vic42/TheWell/pictures/20140920_042.jpg

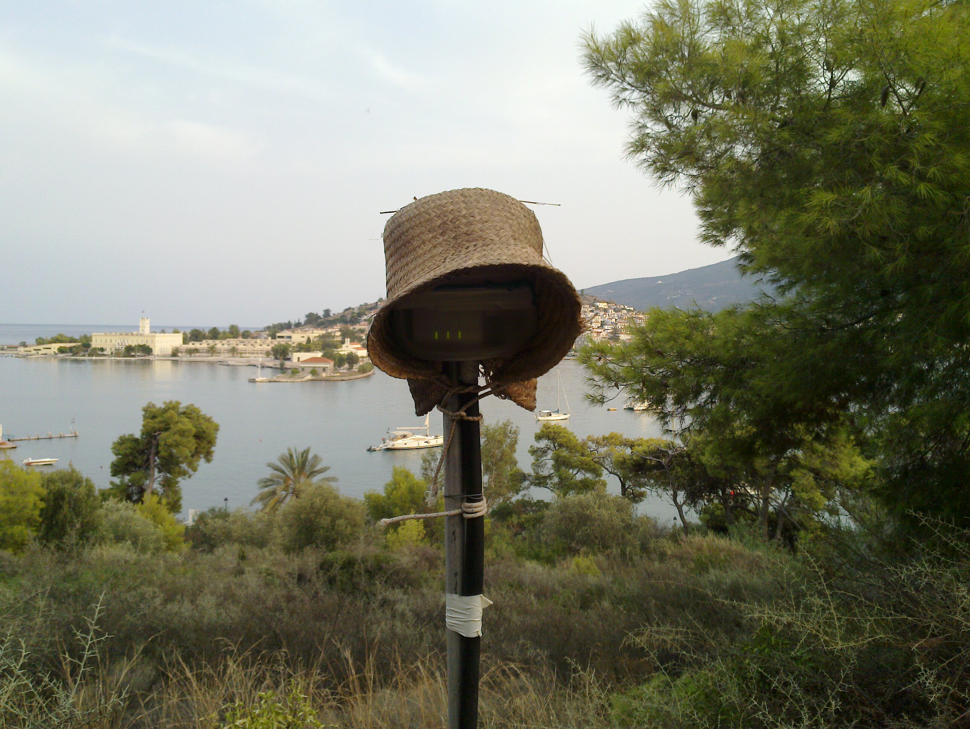
pictures/20140920_042.jpg
