vic42/TheWell/pictures/20140920_026.jpg

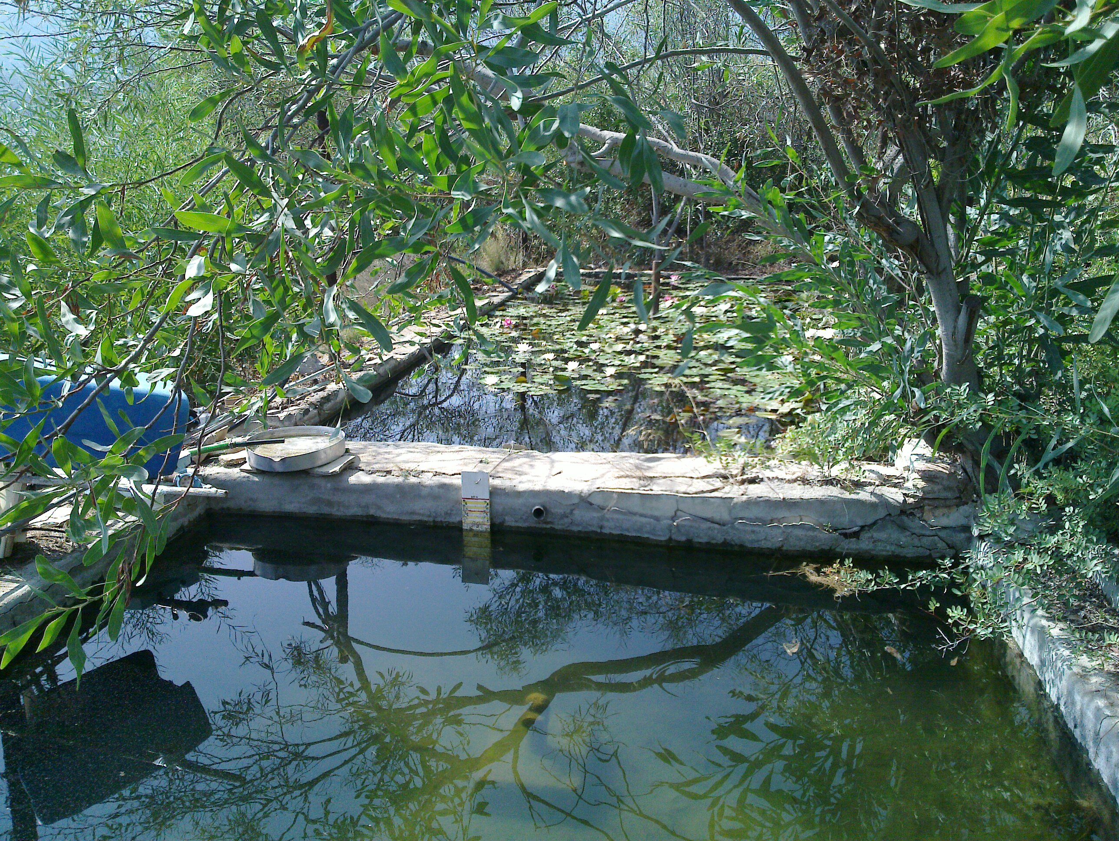
pictures/20140920_026.jpg
