vic42/TheWell/pictures/20140919_006.jpg

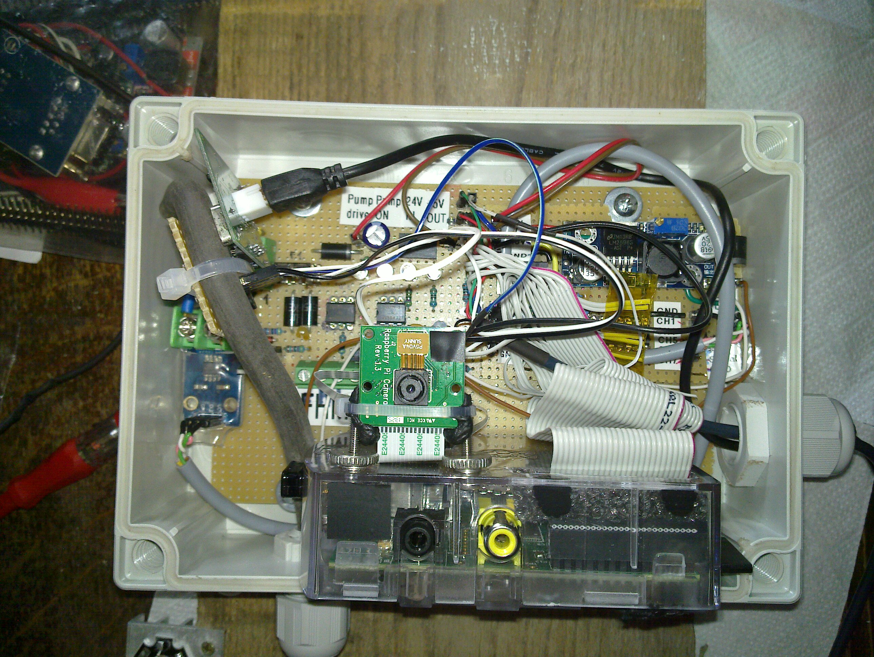
pictures/20140919_006.jpg
