vic42/TheWell/pictures/20140920_013.jpg

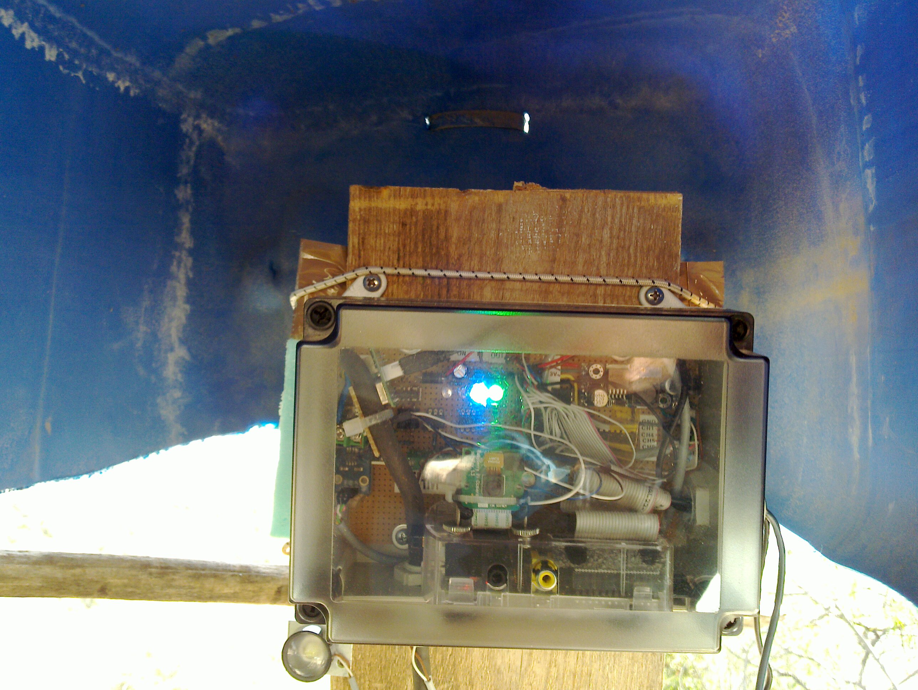
pictures/20140920_013.jpg
