vic42/TheWell/pictures/20140920_014.jpg

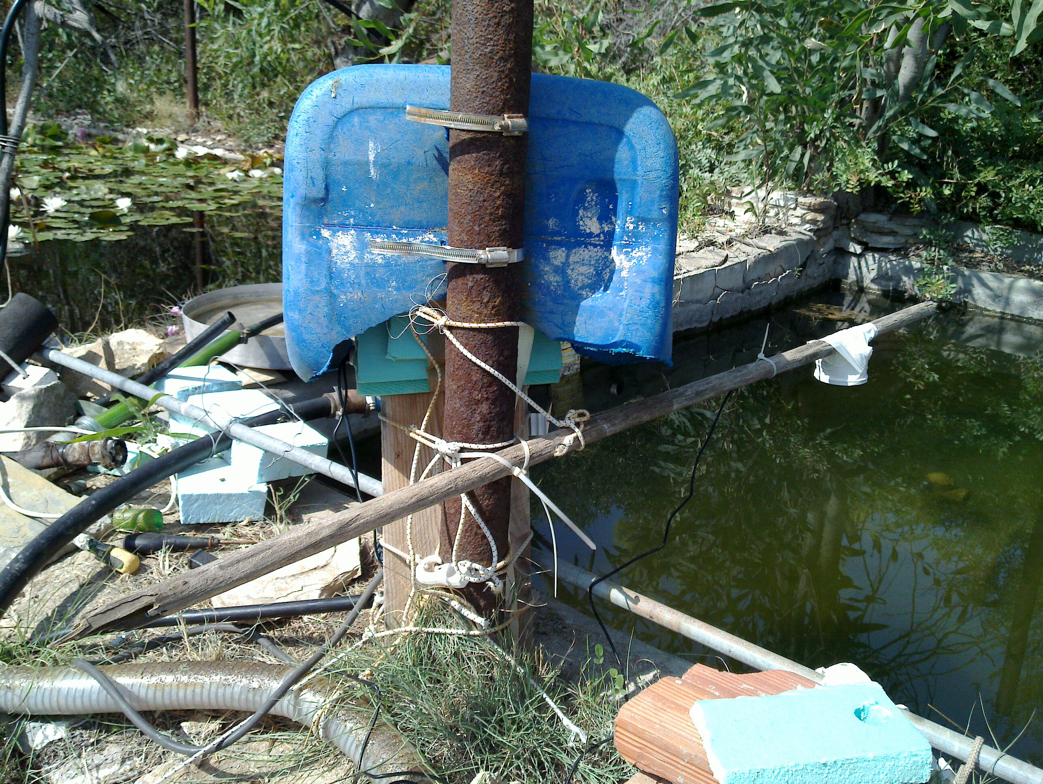
pictures/20140920_014.jpg
