vic42/TheWell/pictures/20140920_032.jpg

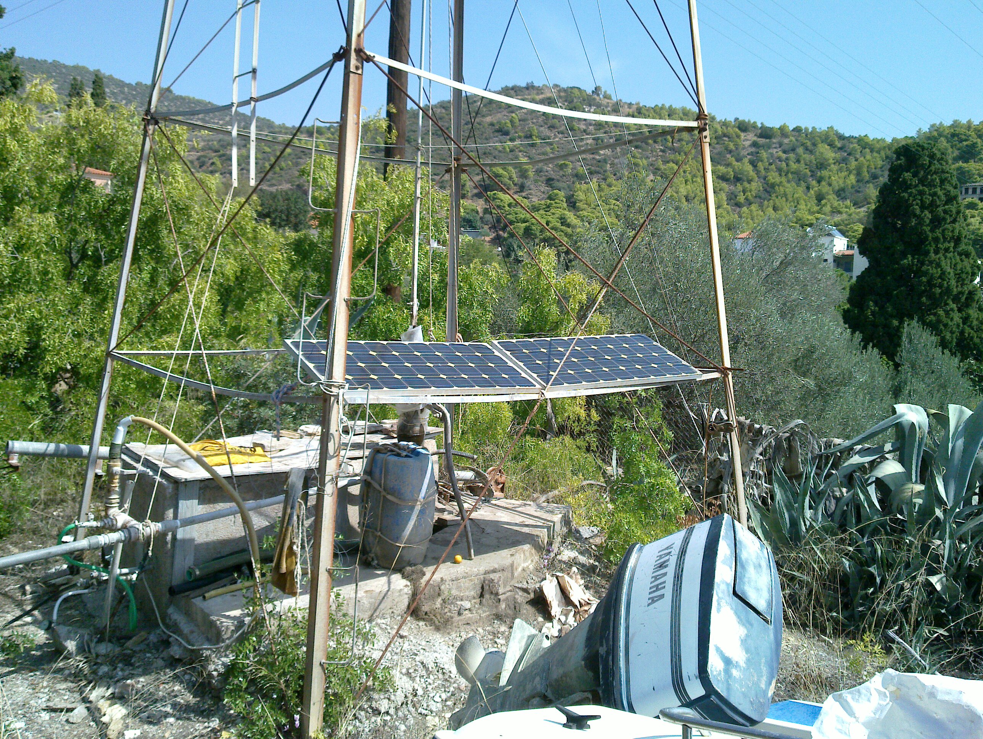
pictures/20140920_032.jpg
