vic42/TheWell/pictures/well1.png

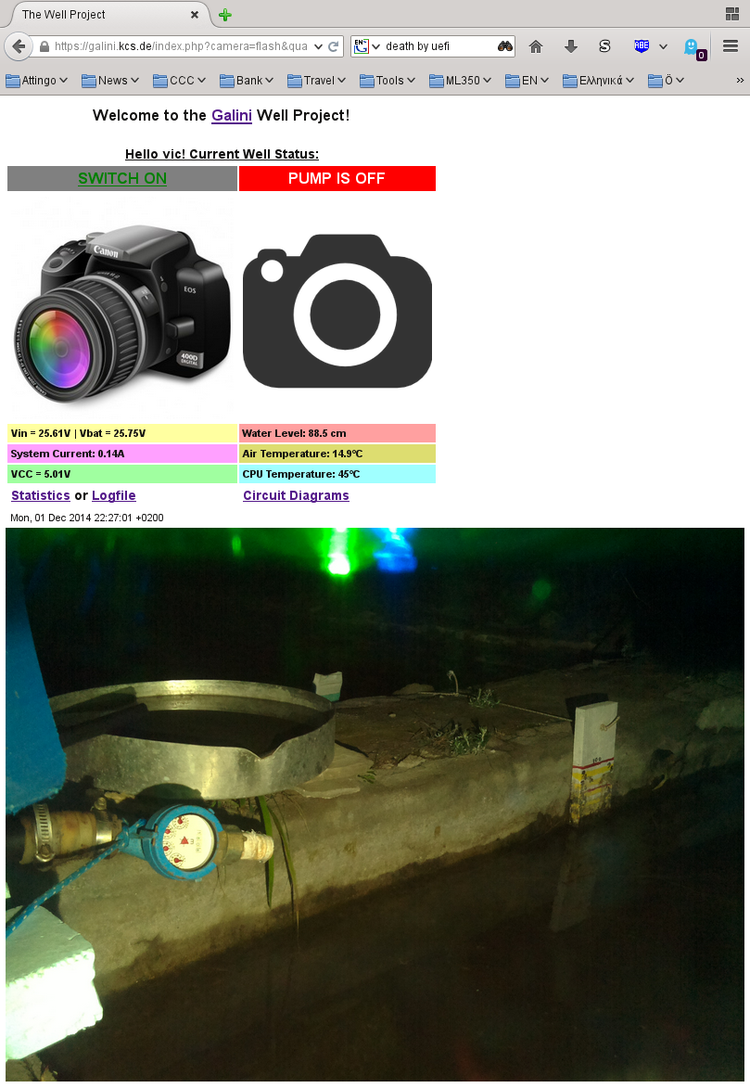
pictures/well1.png
