vic42/TheWell/pictures/well2.png

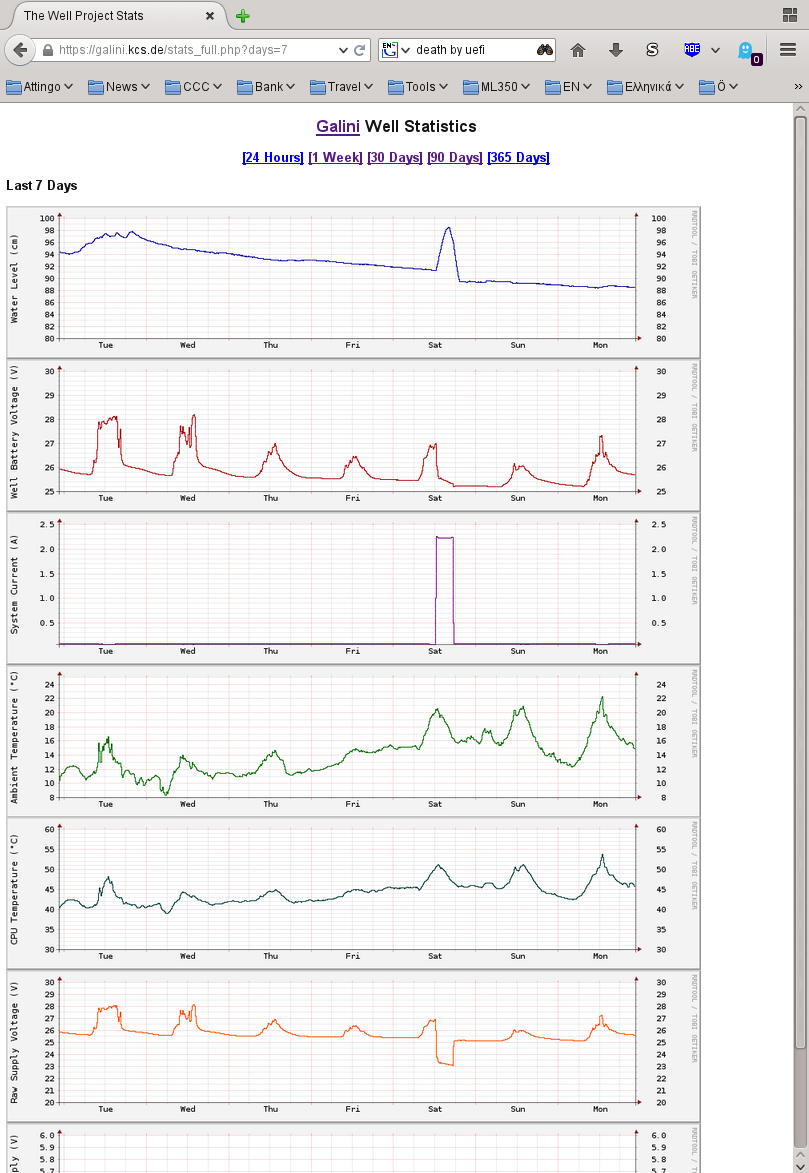
pictures/well2.png
