vic42/TheWell/kicad/well.pdf

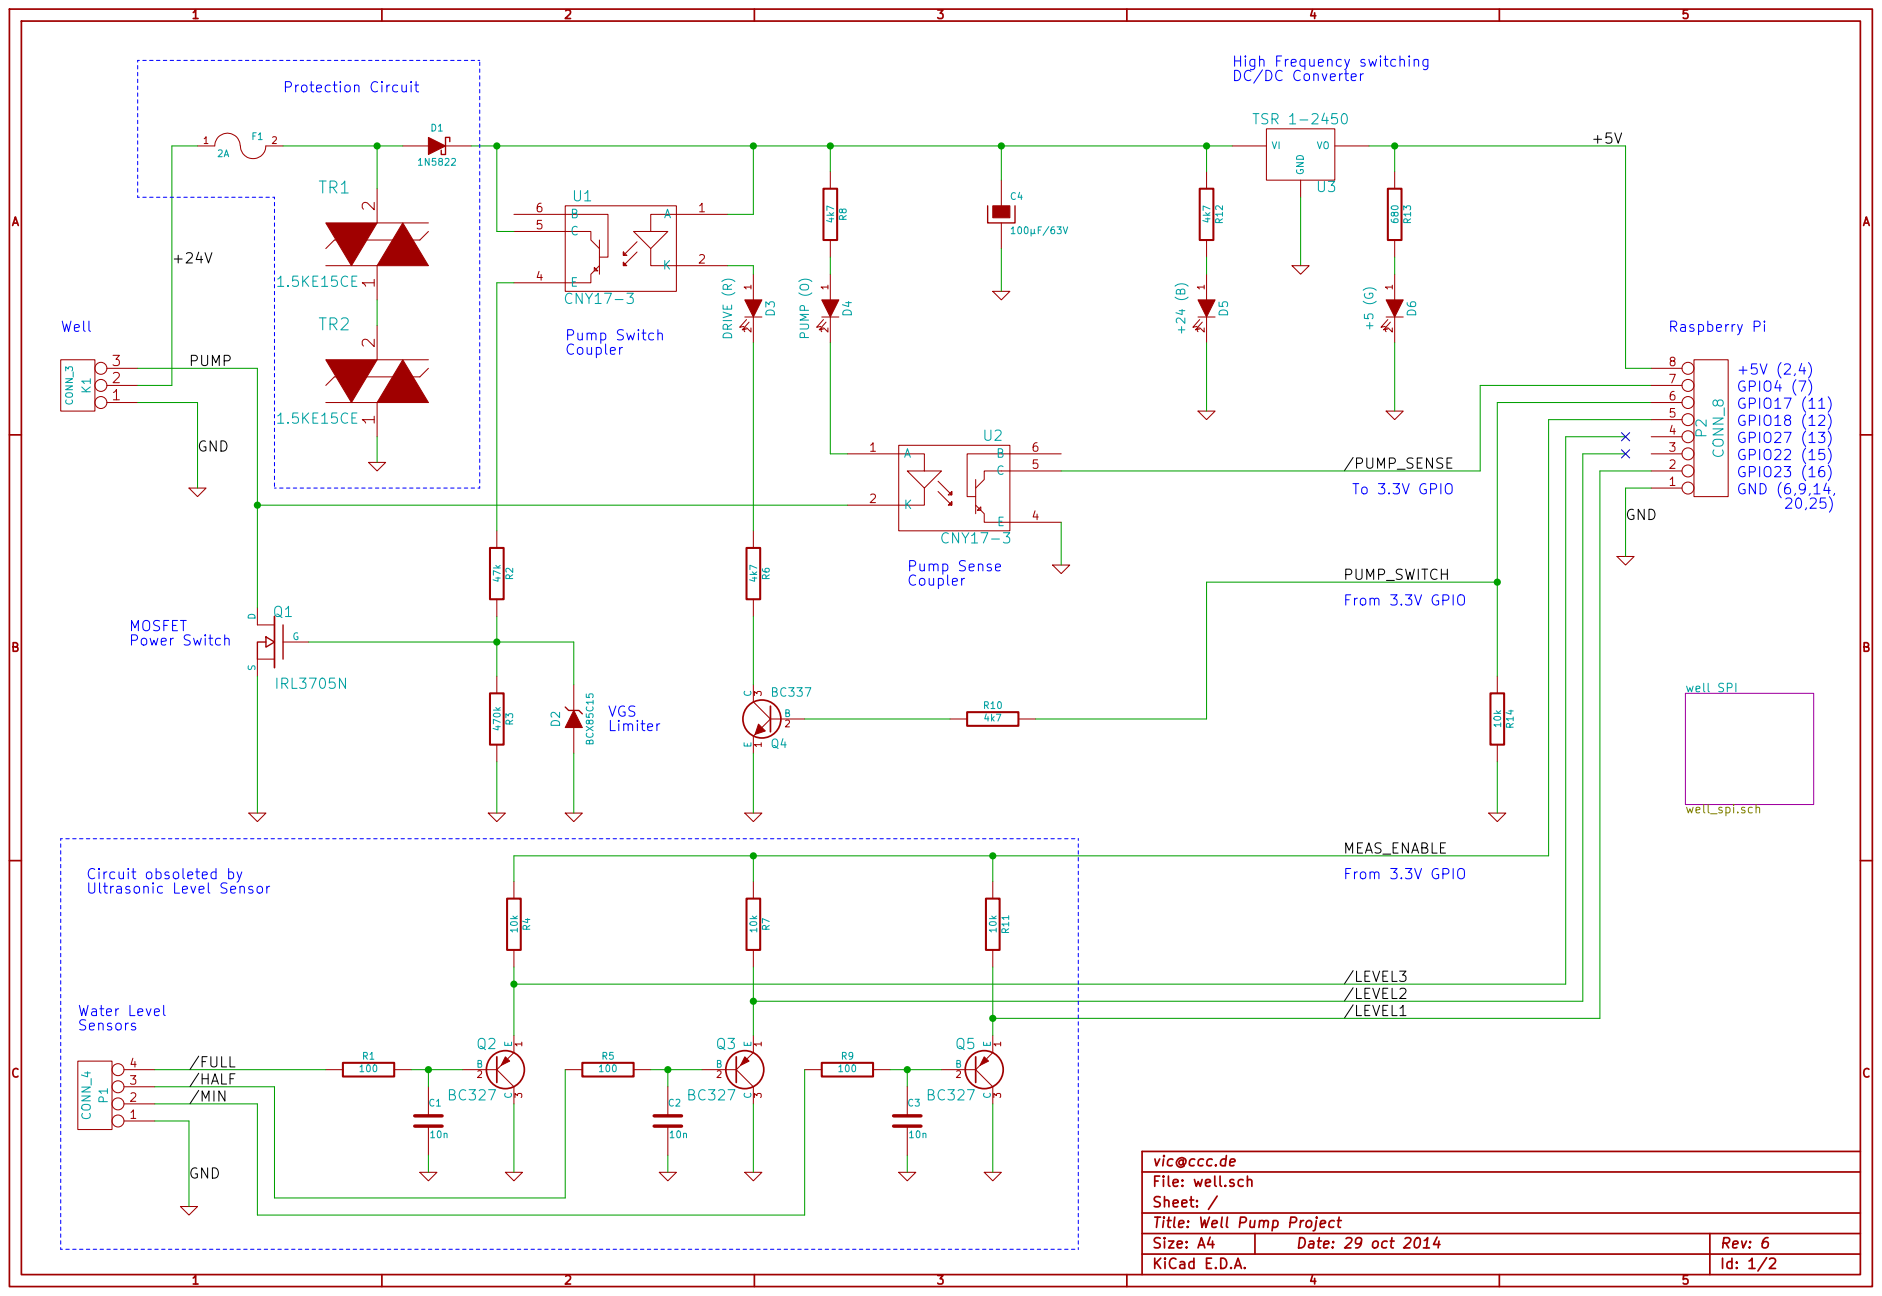
[picture p9: page 1]

DC/DC Converter PUMP

/LEVEL2
/LEVEL1

vic@ccc.de
Title: Well Pump Project File: well.sch Sheet: /

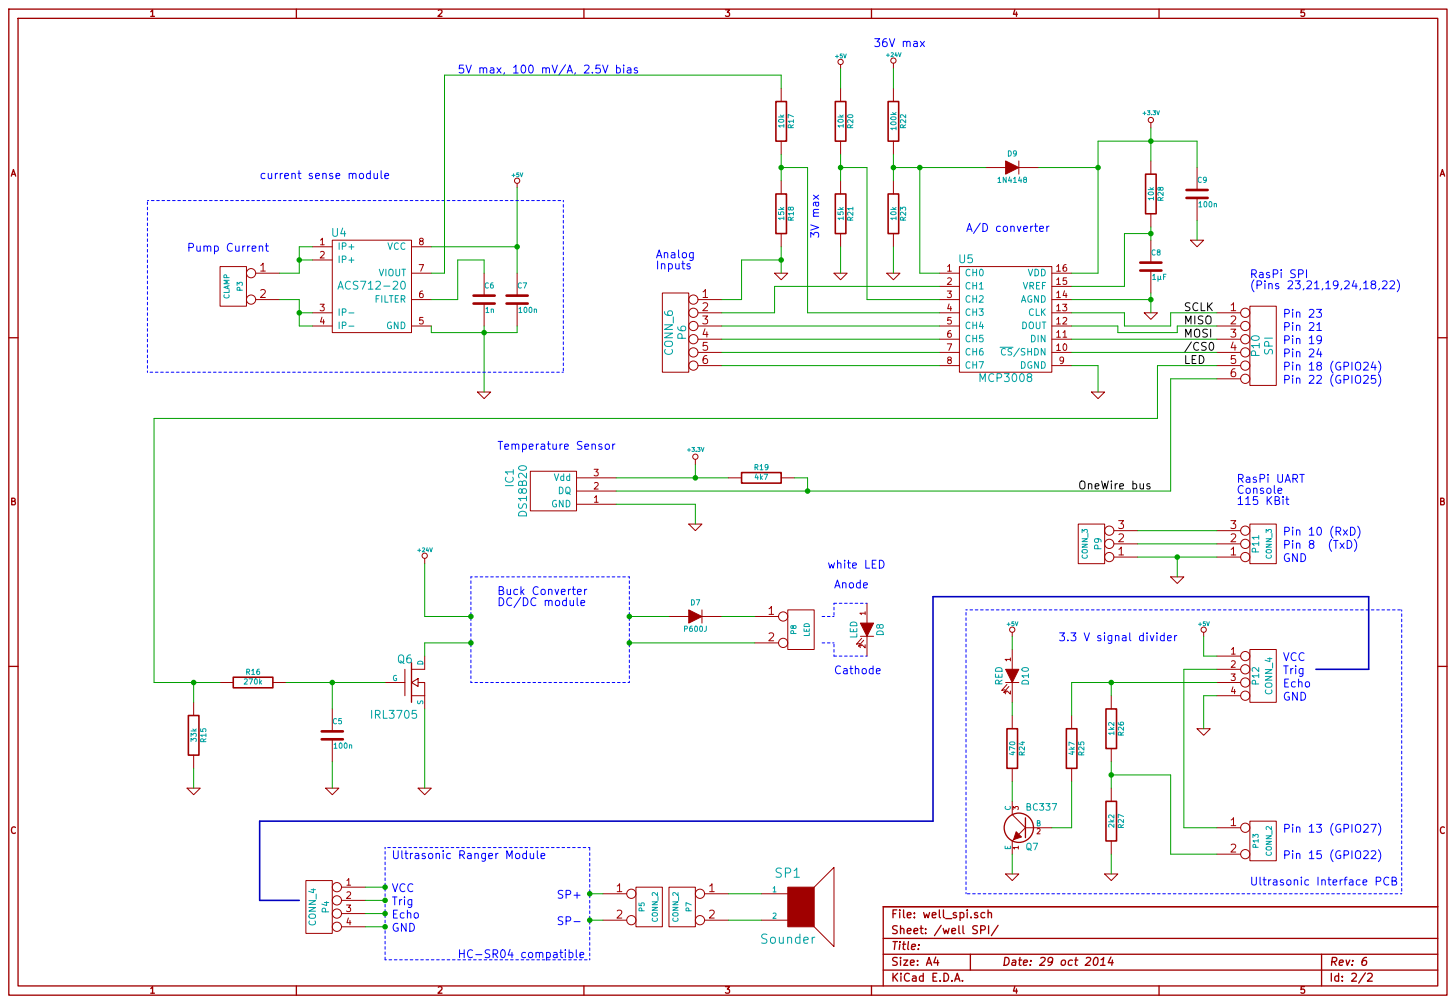
[picture p10: page 2]

A/D converter current sense module

Id: 2/2 Title: File: well_spi.sch
Sheet: /well SPI/
