vic42/TheWell/kicad/well.sch

## KiCad design kicad/well.sch (2017-11-01)

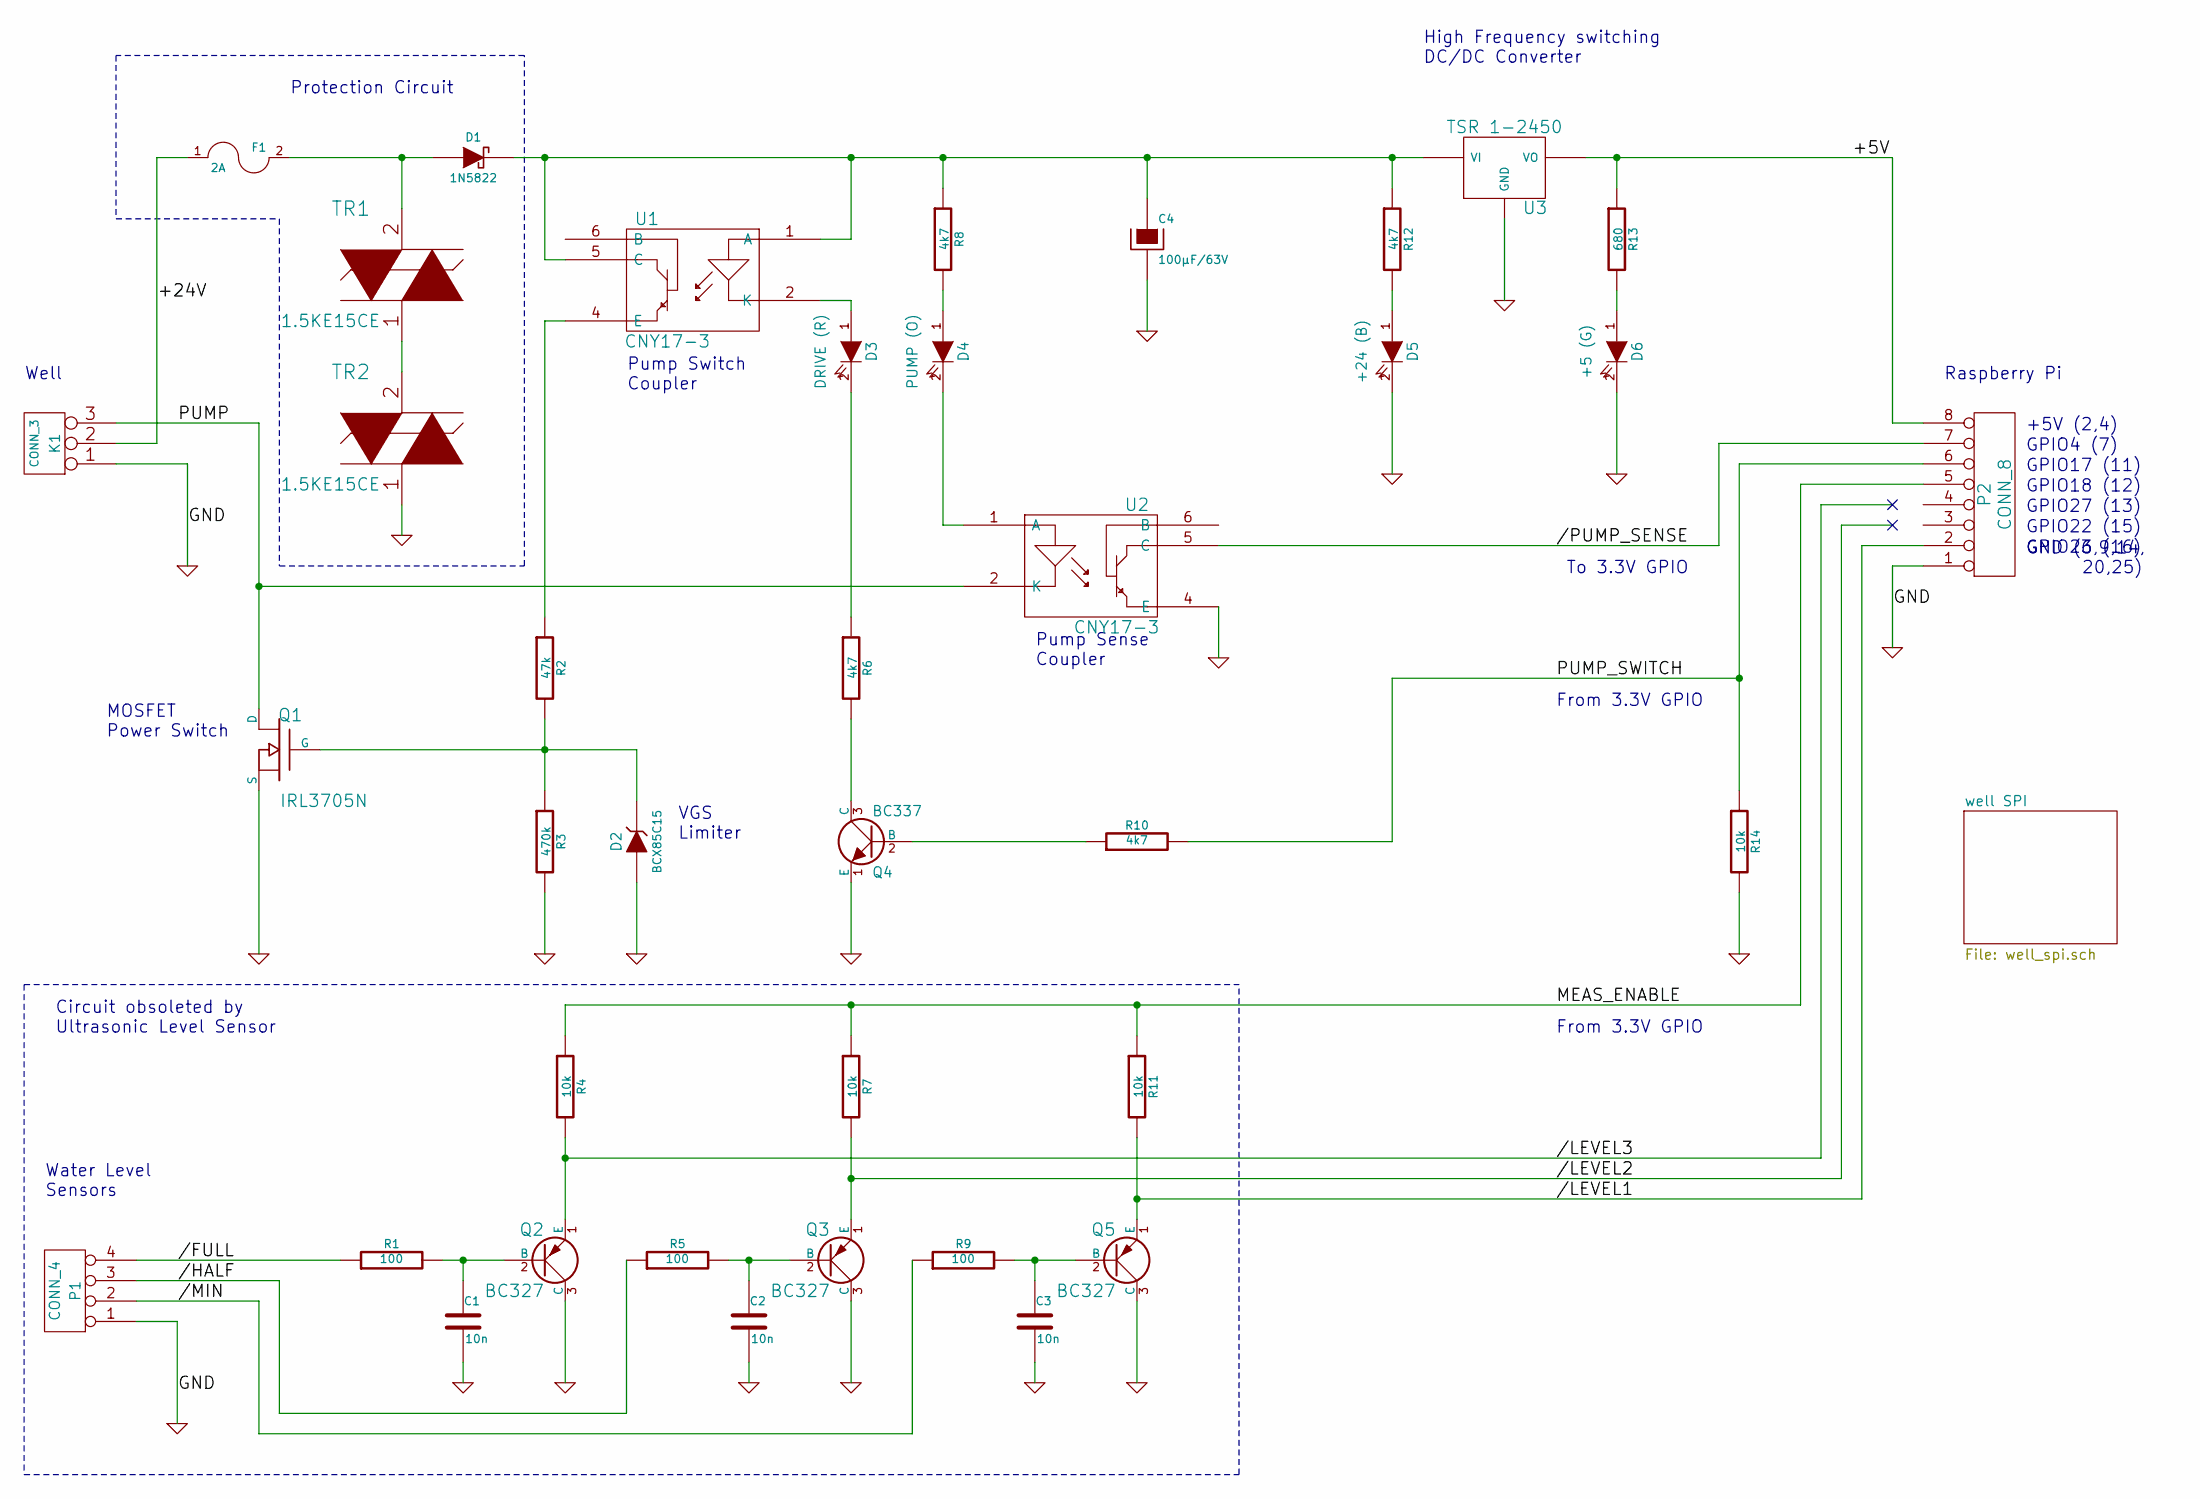
[picture p11: schematic well.sch]

Parts:
C1, C2, C3: 10n
C4: 100µF/63V
D1: 1N5822
D2: BCX85C15
D3: DRIVE (R)
D4: PUMP (O)
D5: +24 (B)
D6: +5 (G)
F1: 2A
K1: CONN_3
P1: CONN_4
P2: CONN_8
Q1: IRL3705N
Q2, Q3, Q5: BC327
Q4: BC337
R1, R5, R9: 100
R2: 47k
R3: 470k
R4, R7, R11, R14: 10k
R6, R8, R10, R12: 4k7
R13: 680
TR1, TR2: 1.5KE15CE
U1, U2: CNY17-3
U3: TSR 1-2450

Connections:
+5V: P2.8, R13.1, U3.VO
+24V: F1.1, K1.2 (PM)
/FULL: P1.4, R1.1
/HALF: P1.3, R5.1
/LEVEL1: P2.2, Q5.1 (E), R11.2
/LEVEL2: Q3.1 (E), R7.2
/LEVEL3: Q2.1 (E), R4.2
/MIN: P1.2, R9.1
/PUMP_SENSE: P2.7, U2.5 (C)
GND: C1.2, C2.2, C3.2, C4.2, D2.1 (A), D5.2 (K), D6.2 (K), K1.1, P1.1, P2.1, Q1.S, Q2.3 (C), Q3.3 (C), Q4.1 (E), Q5.3 (C), R3.2, R14.2, TR2.1, U2.4 (E), U3.GND
MEAS_ENABLE: P2.5, R4.1, R7.1, R11.1
unnamed: C1.1, Q2.2 (B), R1.2
unnamed: C2.1, Q3.2 (B), R5.2
unnamed: C3.1, Q5.2 (B), R9.2
unnamed: C4.1, D1.2 (K), R8.1, R12.1, U1.1 (A), U1.5 (C), U3.VI
unnamed: D1.1 (A), F1.2, TR1.2
unnamed: D2.2 (K), Q1.G, R2.2, R3.1
unnamed: D3.1 (A), U1.2 (K)
unnamed: D3.2 (K), R6.1
unnamed: D4.1 (A), R8.2
unnamed: D4.2 (K), U2.1 (A)
unnamed: D5.1 (A), R12.2
unnamed: D6.1 (A), R13.2
unnamed: Q4.2 (B), R10.1
unnamed: Q4.3 (C), R6.2
unnamed: R2.1, U1.4 (E)
unnamed: TR1.1, TR2.2
PUMP: K1.3, Q1.D, U2.2 (K)
PUMP_SWITCH: P2.6, R10.2, R14.1

Notes on the sheet:
Well
Raspberry Pi
MOSFET Power Switch
VGS Limiter
Protection Circuit
Pump Switch Coupler
Pump Sense Coupler
From 3.3V GPIO
To 3.3V GPIO
High Frequency switching DC/DC Converter
Water Level Sensors
+5V (2,4)
GPIO4 (7)
GPIO17 (11)
GPIO18 (12)
GPIO27 (13)
GPIO22 (15)
GPIO23 (16)
GND (6,9,14, 20,25)
Circuit obsoleted by Ultrasonic Level Sensor
