vic42/TheWell/kicad/well_spi.sch

## KiCad design kicad/well_spi.sch (2017-11-01)

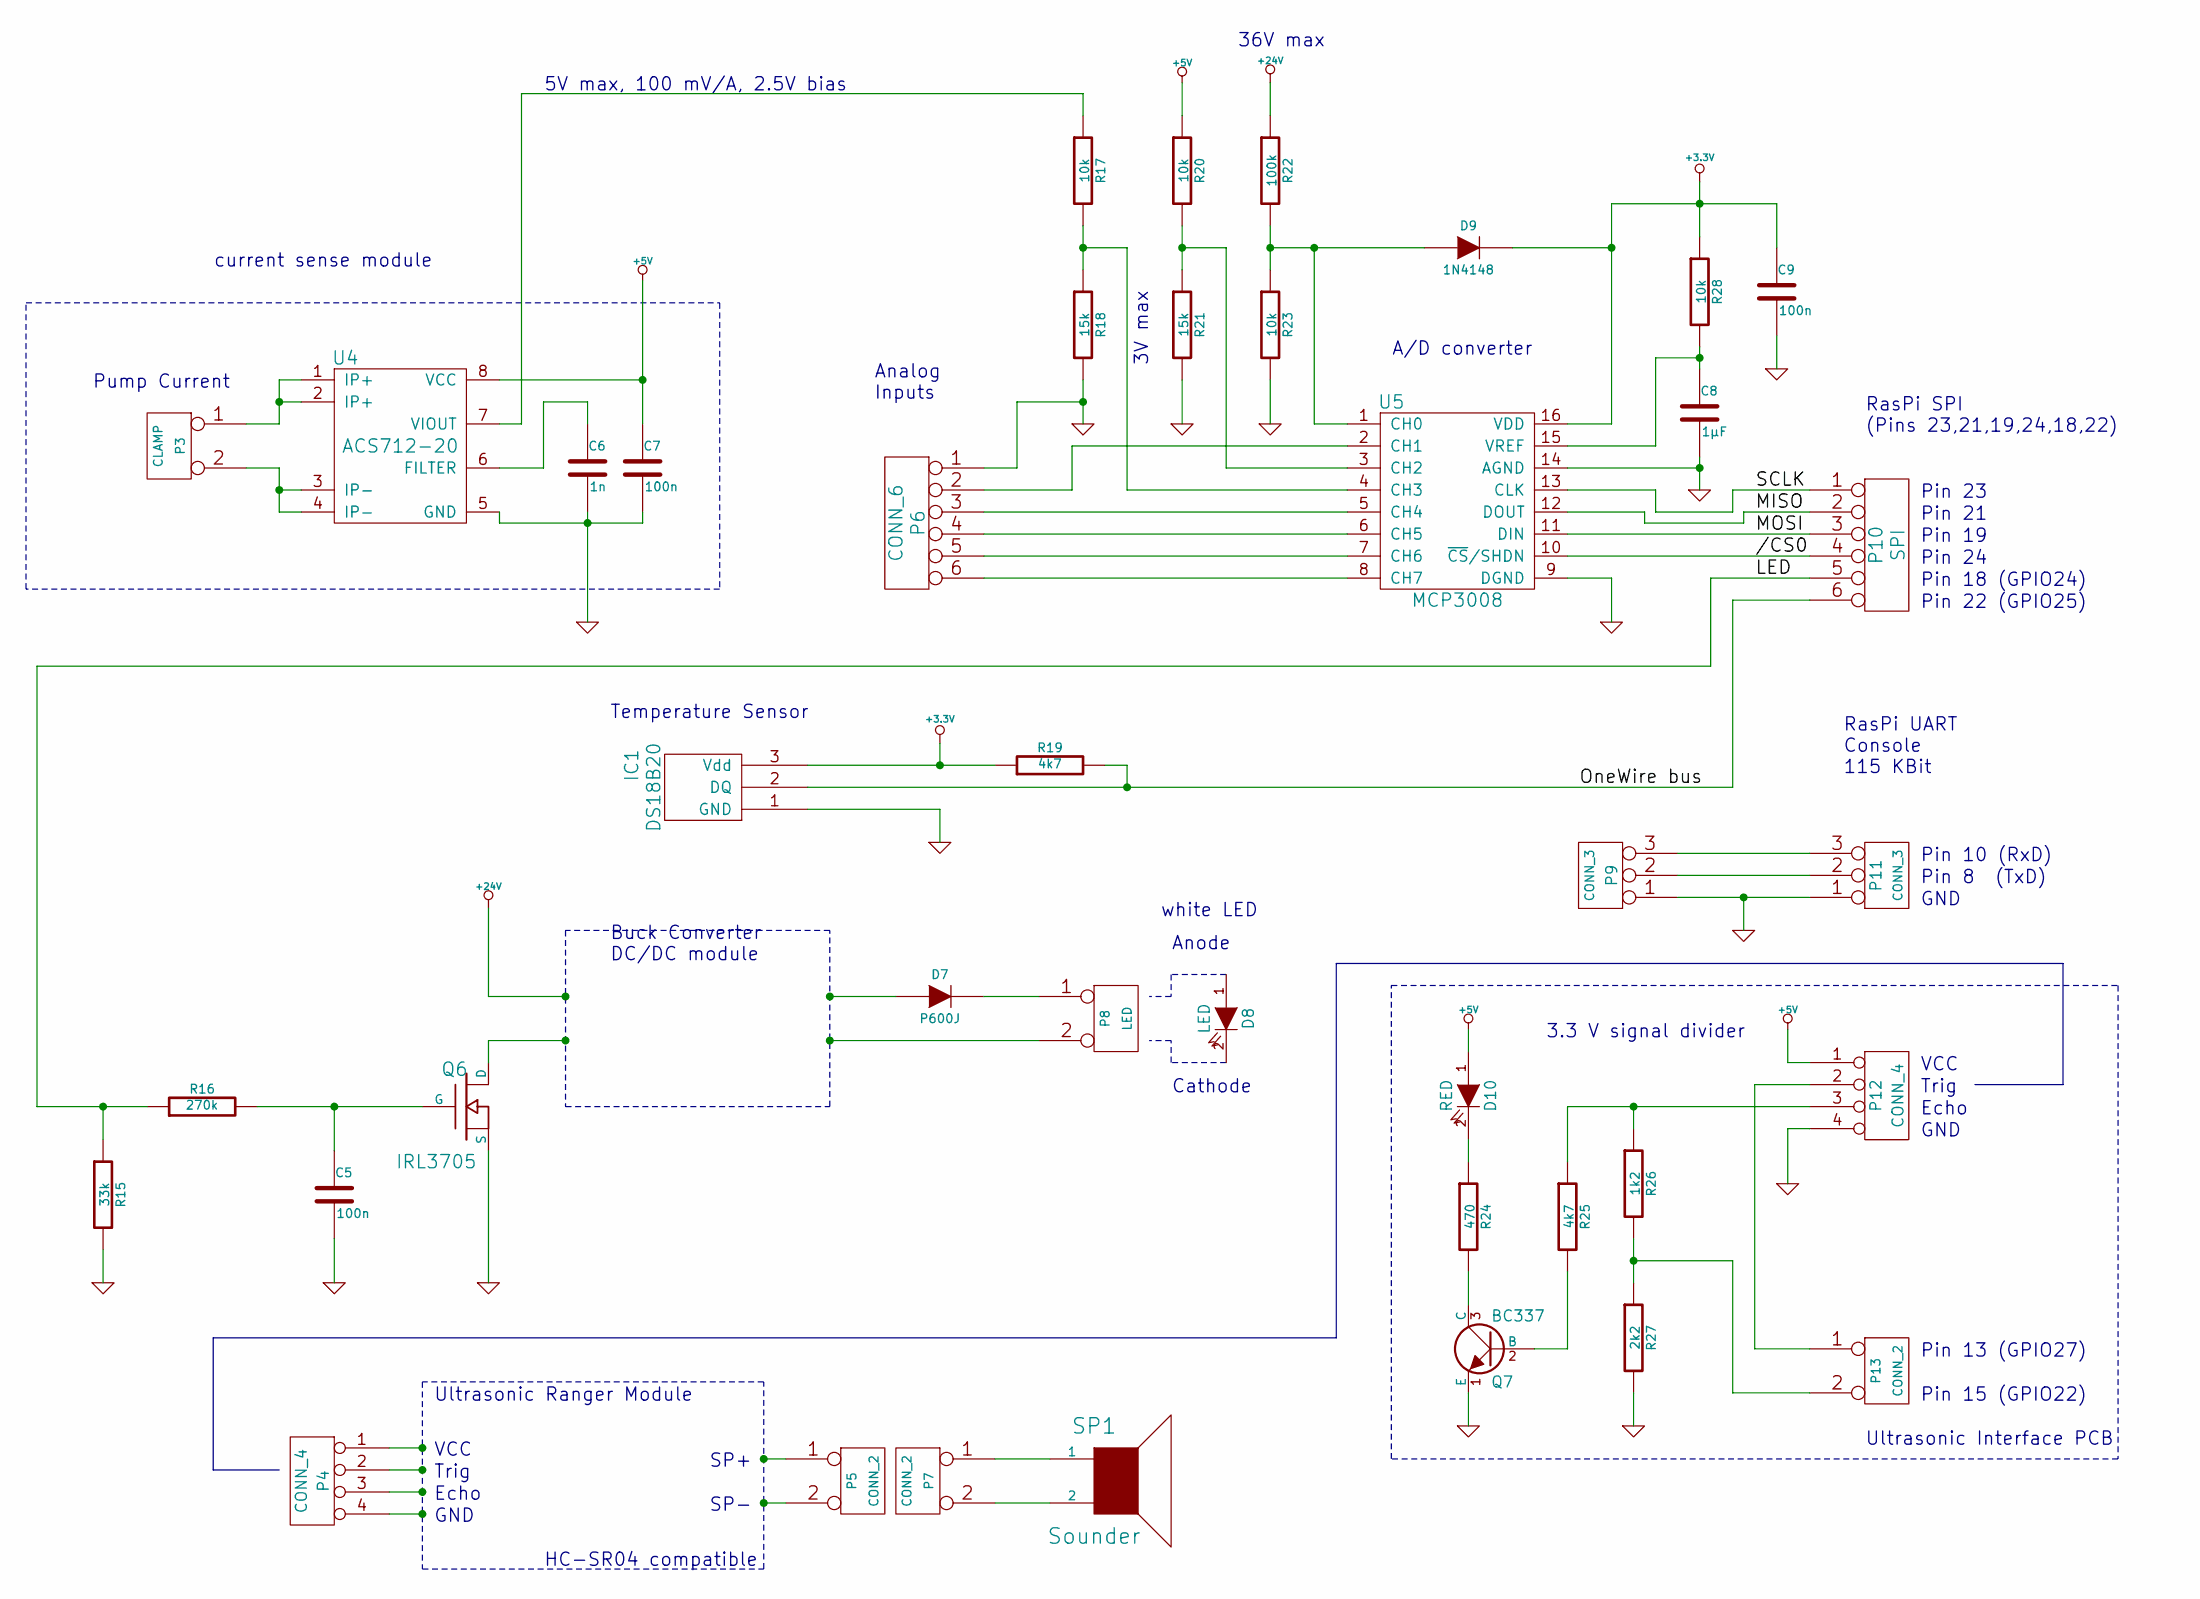
[picture p12: schematic well_spi.sch]

Parts:
C5, C7, C9: 100n
C6: 1n
C8: 1µF
D7: P600J
D8: LED
D9: 1N4148
D10: RED
IC1: DS18B20
P3: CLAMP
P4, P12: CONN_4
P5, P7, P13: CONN_2
P6: CONN_6
P8: LED
P9, P11: CONN_3
P10: SPI
Q6: IRL3705
Q7: BC337
R15: 33k
R16: 270k
R17, R20, R23, R28: 10k
R18, R21: 15k
R19, R25: 4k7
R22: 100k
R24: 470
R26: 1k2
R27: 2k2
SP1: Sounder
U4: ACS712-20
U5: MCP3008

Connections:
+3.3V: C9.1, D9.2 (K), IC1.3 (Vdd), R19.1, R28.1, U5.16 (VDD)
+5V: C7.1, D10.1 (A), P12.1, R20.1, U4.8 (VCC)
+24V: R22.1
/CS0: P10.4, U5.10 (~CS~/SHDN)
GND: C5.2, C6.2, C7.2, C8.2, C9.2, IC1.1 (GND), P6.1, P9.1, P11.1, P12.4, Q6.S, Q7.1 (E), R15.2, R18.2, R21.2, R23.2, R27.2, U4.5 (GND), U5.9 (DGND), U5.14 (AGND)
LED: P10.5, R15.1, R16.1
MISO: P10.2, U5.12 (DOUT)
MOSI: P10.3, U5.11 (DIN)
unnamed: C5.1, Q6.G, R16.2
unnamed: C6.1, U4.6 (FILTER)
unnamed: C8.1, R28.2, U5.15 (VREF)
unnamed: D7.2 (K), P8.1
unnamed: D9.1 (A), R22.2, R23.1, U5.1 (CH0)
unnamed: D10.2 (K), R24.1
unnamed: P3.1, U4.1 (IP+), U4.2 (IP+)
unnamed: P3.2 (PM), U4.3 (IP-), U4.4 (IP-)
unnamed: P6.2, U5.2 (CH1)
unnamed: P6.3, U5.5 (CH4)
unnamed: P6.4, U5.6 (CH5)
unnamed: P6.5, U5.7 (CH6)
unnamed: P6.6, U5.8 (CH7)
unnamed: P7.1, SP1.1
unnamed: P7.2 (PM), SP1.2
unnamed: P9.2 (PM), P11.2 (PM)
unnamed: P9.3, P11.3
unnamed: P12.2, P13.1
unnamed: P12.3, R25.1, R26.1
unnamed: P13.2 (PM), R26.2, R27.1
unnamed: Q7.2 (B), R25.2
unnamed: Q7.3 (C), R24.2
unnamed: R17.1, U4.7 (VIOUT)
unnamed: R17.2, R18.1, U5.4 (CH3)
unnamed: R20.2, R21.1, U5.3 (CH2)
OneWire bus: IC1.2 (DQ), P10.6, R19.2
SCLK: P10.1, U5.13 (CLK)

Notes on the sheet:
A/D converter
current sense module
5V max, 100 mV/A, 2.5V bias
RasPi SPI (Pins 23,21,19,24,18,22)
Pump Current
Anode
Cathode
3V max
Pin 18 (GPIO24)
white LED
36V max
Buck Converter DC/DC module
Analog Inputs
Pin 23
Pin 21
Pin 19
Pin 24
GND
Pin 8 (TxD)
Pin 10 (RxD)
RasPi UART Console 115 KBit
Pin 13 (GPIO27)
Pin 15 (GPIO22)
VCC
Trig
Echo
3.3 V signal divider
Ultrasonic Interface PCB
SP+
SP-
Ultrasonic Ranger Module
HC-SR04 compatible
Pin 22 (GPIO25)
Temperature Sensor
